Cubesat-EPS-Project/Final_EPS_Version2/Docs/EPS_FINAL_FRONT.png

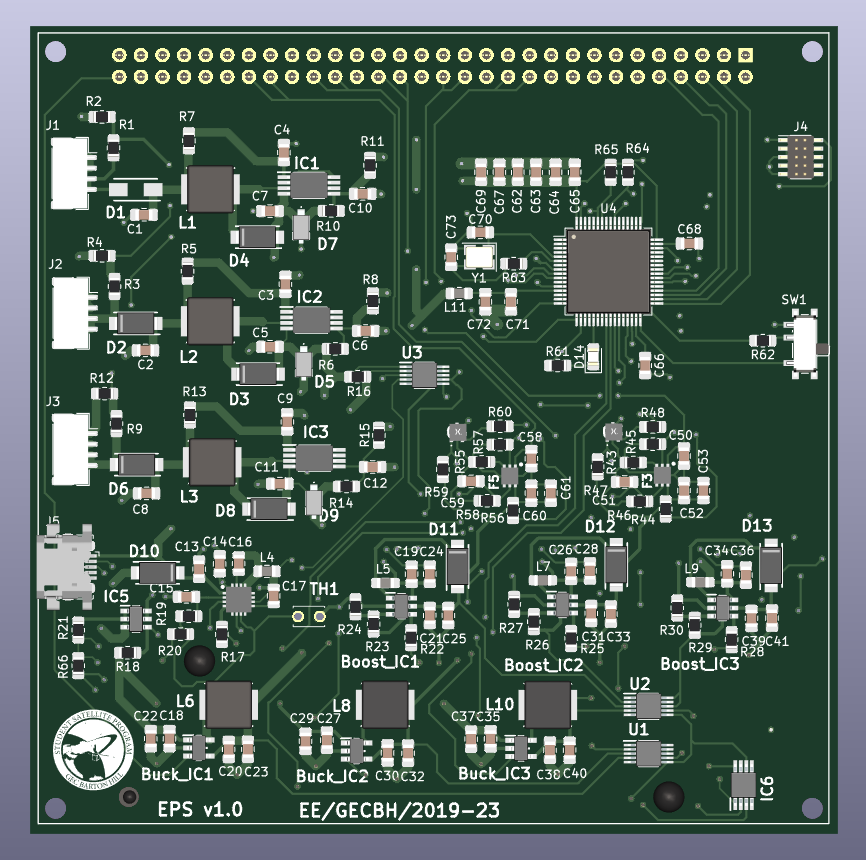
Docs/EPS_FINAL_FRONT.png
