Cubesat-EPS-Project/Final_EPS_Version2/FinalBoardCircuits/FinalBoardCircuits.kicad_pcb

## KiCad design FinalBoardCircuits/FinalBoardCircuits.kicad_pcb (2023-06-03)

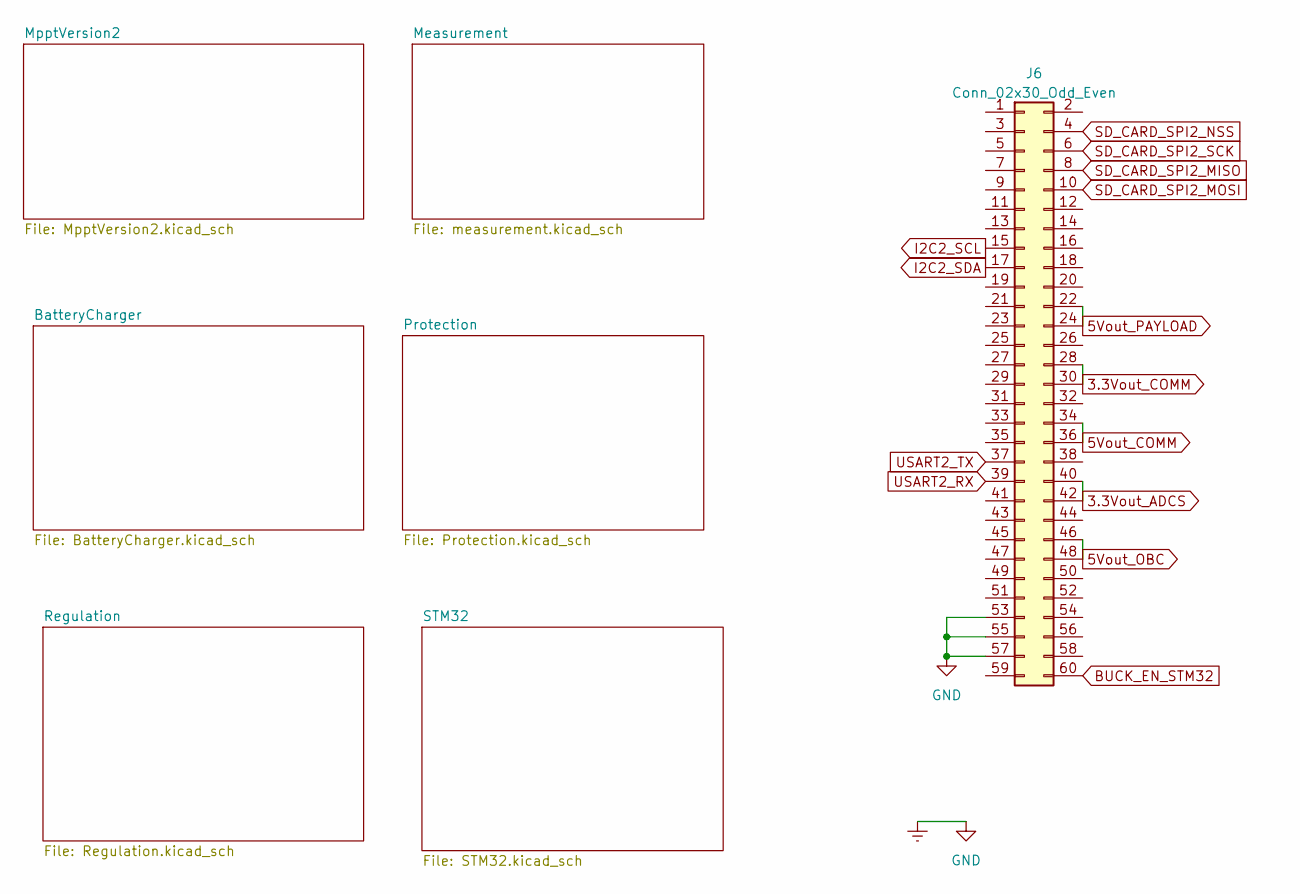
[picture p3: schematic FinalBoardCircuits.kicad_sch]

Parts:
J6: Conn_02x30_Odd_Even; PinSocket_2x30_P2.54mm_Vertical

Connections:
3.3Vout_ADCS: J6.40, J6.42; also elsewhere on the board
3.3Vout_COMM: J6.28, J6.30; also elsewhere on the board
5Vout_COMM: J6.34, J6.36; also elsewhere on the board
5Vout_OBC: J6.46, J6.48; also elsewhere on the board
5Vout_PAYLOAD: J6.22, J6.24; also elsewhere on the board
BUCK_EN_STM32: J6.60; also elsewhere on the board
I2C2_SCL: J6.15; also elsewhere on the board
I2C2_SDA: J6.17; also elsewhere on the board
SD_CARD_SPI2_MISO: J6.8; also elsewhere on the board
SD_CARD_SPI2_MOSI: J6.10; also elsewhere on the board
SD_CARD_SPI2_NSS: J6.4; also elsewhere on the board
SD_CARD_SPI2_SCK: J6.6; also elsewhere on the board
USART2_RX: J6.39; also elsewhere on the board
USART2_TX: J6.37; also elsewhere on the board

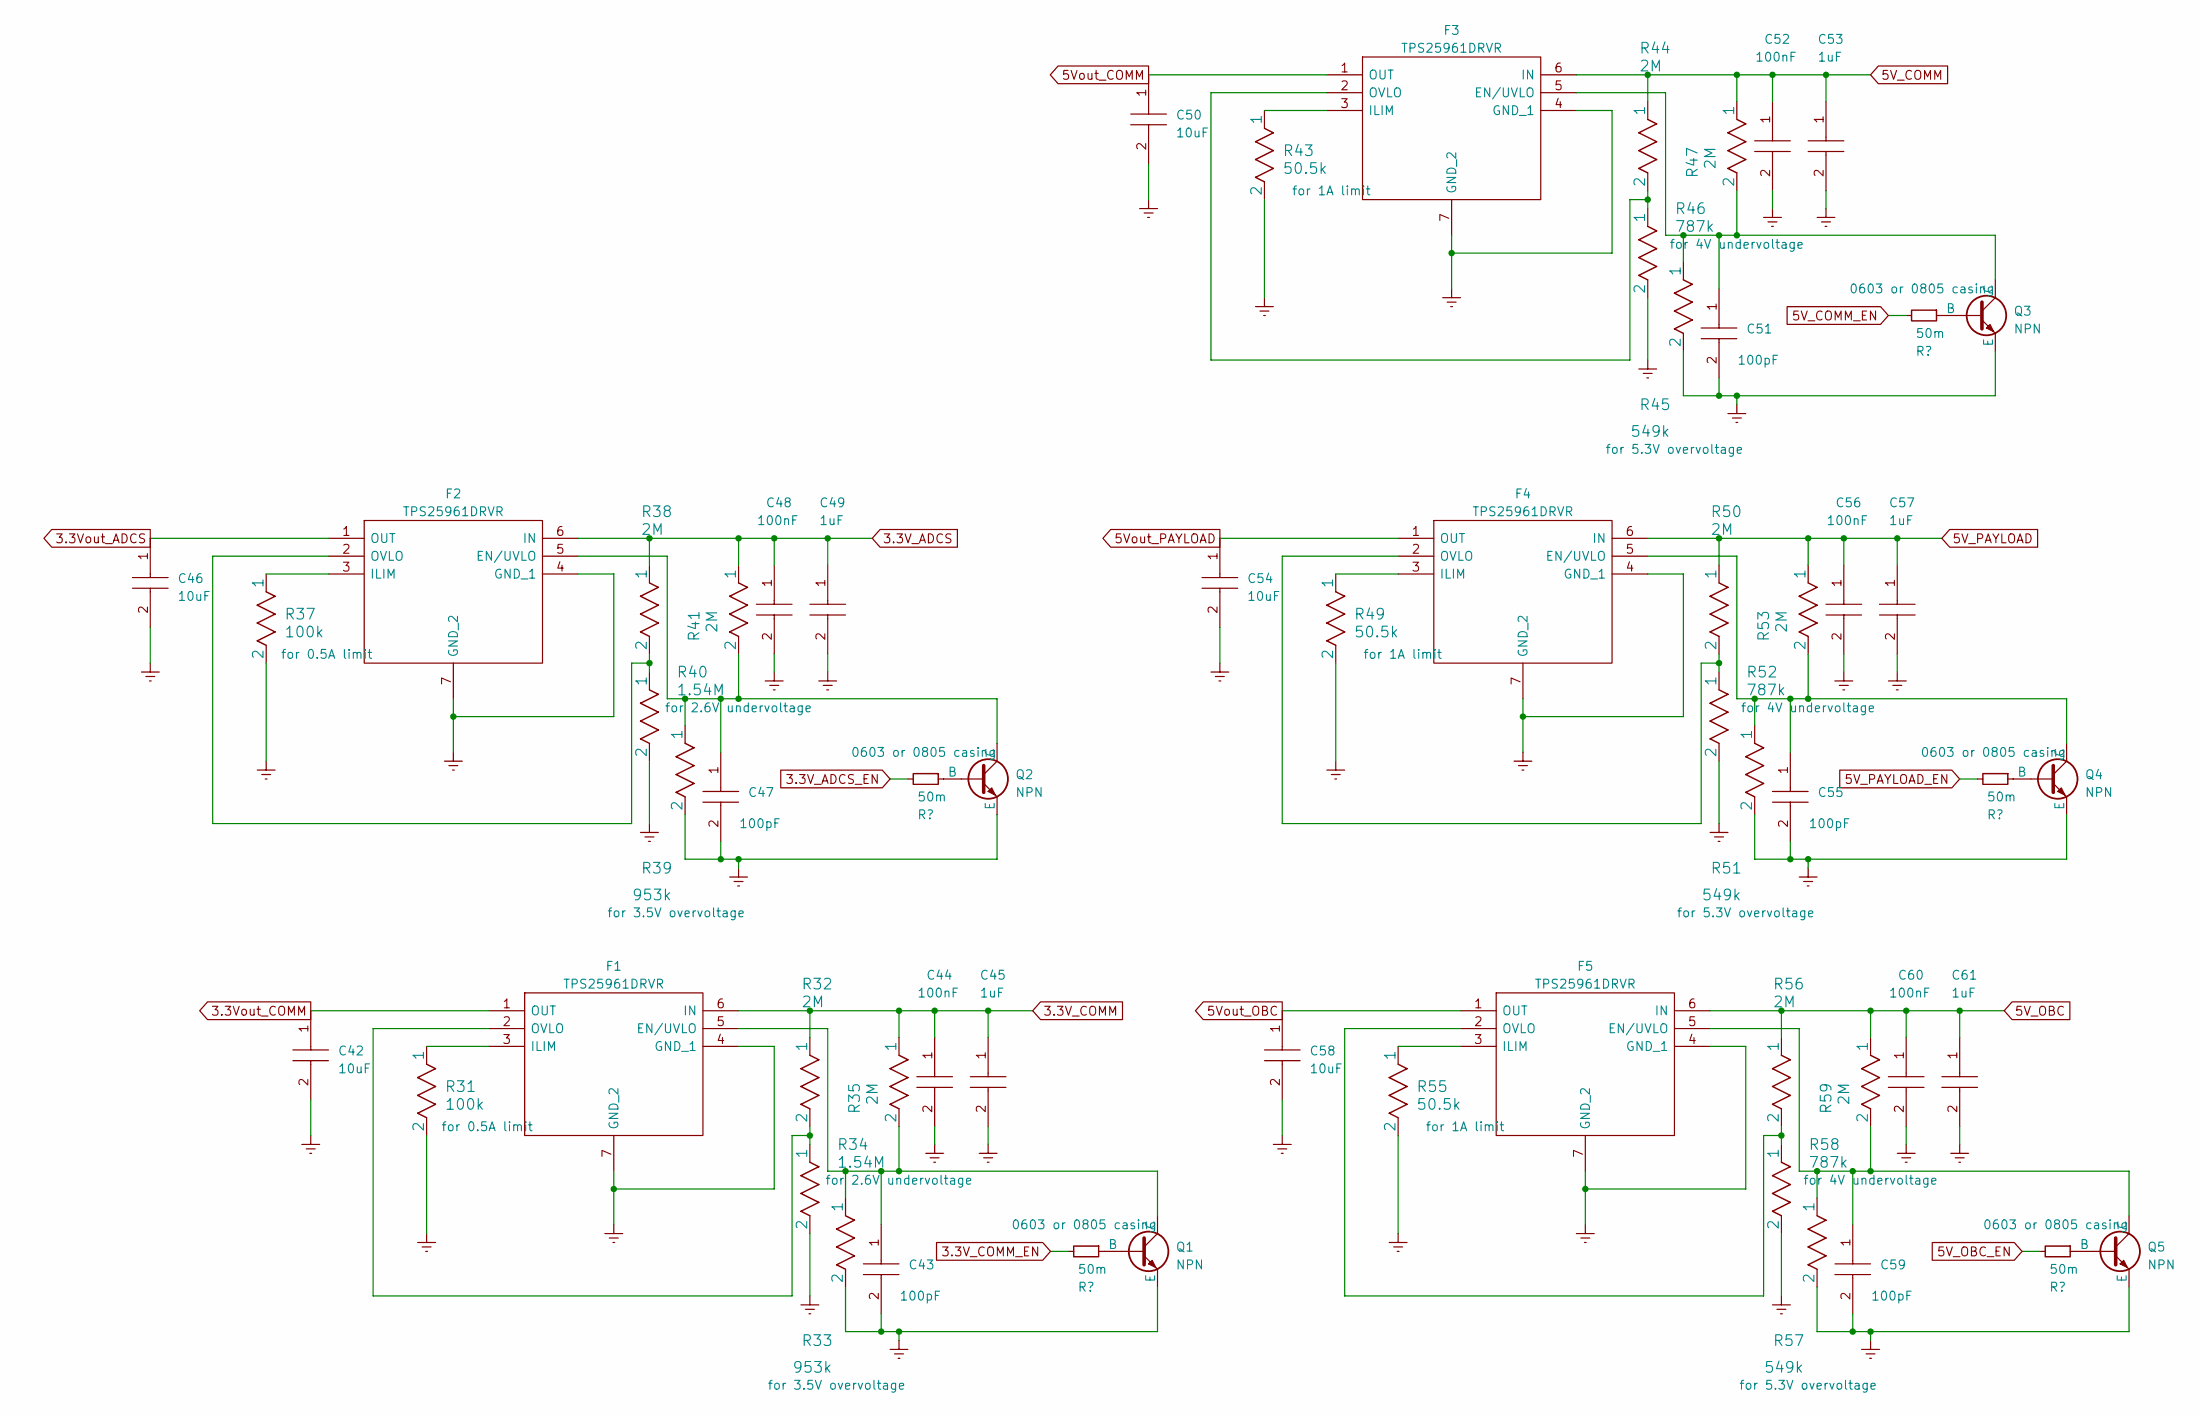
[picture p4: schematic Protection.kicad_sch]

Parts:
C42, C46, C50, C54, C58: 10uF; C_0805_2012Metric_Pad1.18x1.45mm_HandSolder; Mouser Part Number 581-0805YC106KAT2A
C43, C47, C51, C55, C59: 100pF; C_0805_2012Metric_Pad1.18x1.45mm_HandSolder; Mouser Part Number 80-C0402C101K3RAUTO
C44, C48, C52, C56, C60: 100nF; C_0805_2012Metric_Pad1.18x1.45mm_HandSolder; Mouser Part Number 810-C1005X7R1C104K
C45, C49, C53, C57, C61: 1uF; C_0805_2012Metric_Pad1.18x1.45mm_HandSolder; Mouser Part Number 80-C2220X105K2RAUTO
F1, F2, F3, F4, F5: TPS25961DRVR; SON65P200X200X80-7N; Mouser Part Number 595-TPS25961DRVR
Q1, Q2, Q3, Q4, Q5: NPN; PBSS4310PASQX
R31, R37: 100k; R_0805_2012Metric_Pad1.20x1.40mm_HandSolder
R32, R35, R38, R41, R44, R47, R50, R53, R56, R59: 2M; R_0805_2012Metric_Pad1.20x1.40mm_HandSolder
R33, R39: 953k; R_0805_2012Metric_Pad1.20x1.40mm_HandSolder
R34, R40: 1.54M; R_0805_2012Metric_Pad1.20x1.40mm_HandSolder
R36, R42, R48, R54, R60: 50m; R_0805_2012Metric_Pad1.20x1.40mm_HandSolder
R43, R49, R55: 50.5k; R_0805_2012Metric_Pad1.20x1.40mm_HandSolder
R45, R51, R57: 549k; R_0805_2012Metric_Pad1.20x1.40mm_HandSolder
R46, R52, R58: 787k; R_0805_2012Metric_Pad1.20x1.40mm_HandSolder

Connections:
3.3V_ADCS: C48.1, C49.1, F2.6 (IN), R38.1, R41.1; also elsewhere on the board
3.3V_ADCS_EN: R42.2; also elsewhere on the board
3.3V_COMM: C44.1, C45.1, F1.6 (IN), R32.1, R35.1; also elsewhere on the board
3.3V_COMM_EN: R36.2; also elsewhere on the board
3.3Vout_ADCS: C46.1, F2.1 (OUT); also elsewhere on the board
3.3Vout_COMM: C42.1, F1.1 (OUT); also elsewhere on the board
5V_COMM: C52.1, C53.1, F3.6 (IN), R44.1, R47.1; also elsewhere on the board
5V_COMM_EN: R48.2; also elsewhere on the board
5V_OBC: C60.1, C61.1, F5.6 (IN), R56.1, R59.1; also elsewhere on the board
5V_OBC_EN: R60.2; also elsewhere on the board
5V_PAYLOAD: C56.1, C57.1, F4.6 (IN), R50.1, R53.1; also elsewhere on the board
5V_PAYLOAD_EN: R54.2; also elsewhere on the board
5Vout_COMM: C50.1, F3.1 (OUT); also elsewhere on the board
5Vout_OBC: C58.1, F5.1 (OUT); also elsewhere on the board
5Vout_PAYLOAD: C54.1, F4.1 (OUT); also elsewhere on the board
unnamed: C43.1, F1.5 (EN/UVLO), Q1.1 (C), R34.1, R35.2
unnamed: F1.3 (ILIM), R31.1
unnamed: F1.2 (OVLO), R32.2, R33.1
unnamed: C47.1, F2.5 (EN/UVLO), Q2.1 (C), R40.1, R41.2
unnamed: F2.3 (ILIM), R37.1
unnamed: F2.2 (OVLO), R38.2, R39.1
unnamed: C51.1, F3.5 (EN/UVLO), Q3.1 (C), R46.1, R47.2
unnamed: F3.3 (ILIM), R43.1
unnamed: F3.2 (OVLO), R44.2, R45.1
unnamed: C55.1, F4.5 (EN/UVLO), Q4.1 (C), R52.1, R53.2
unnamed: F4.3 (ILIM), R49.1
unnamed: F4.2 (OVLO), R50.2, R51.1
unnamed: C59.1, F5.5 (EN/UVLO), Q5.1 (C), R58.1, R59.2
unnamed: F5.3 (ILIM), R55.1
unnamed: F5.2 (OVLO), R56.2, R57.1
unnamed: Q1.2 (B), R36.1
unnamed: Q2.2 (B), R42.1
unnamed: Q3.2 (B), R48.1
unnamed: Q4.2 (B), R54.1
unnamed: Q5.2 (B), R60.1

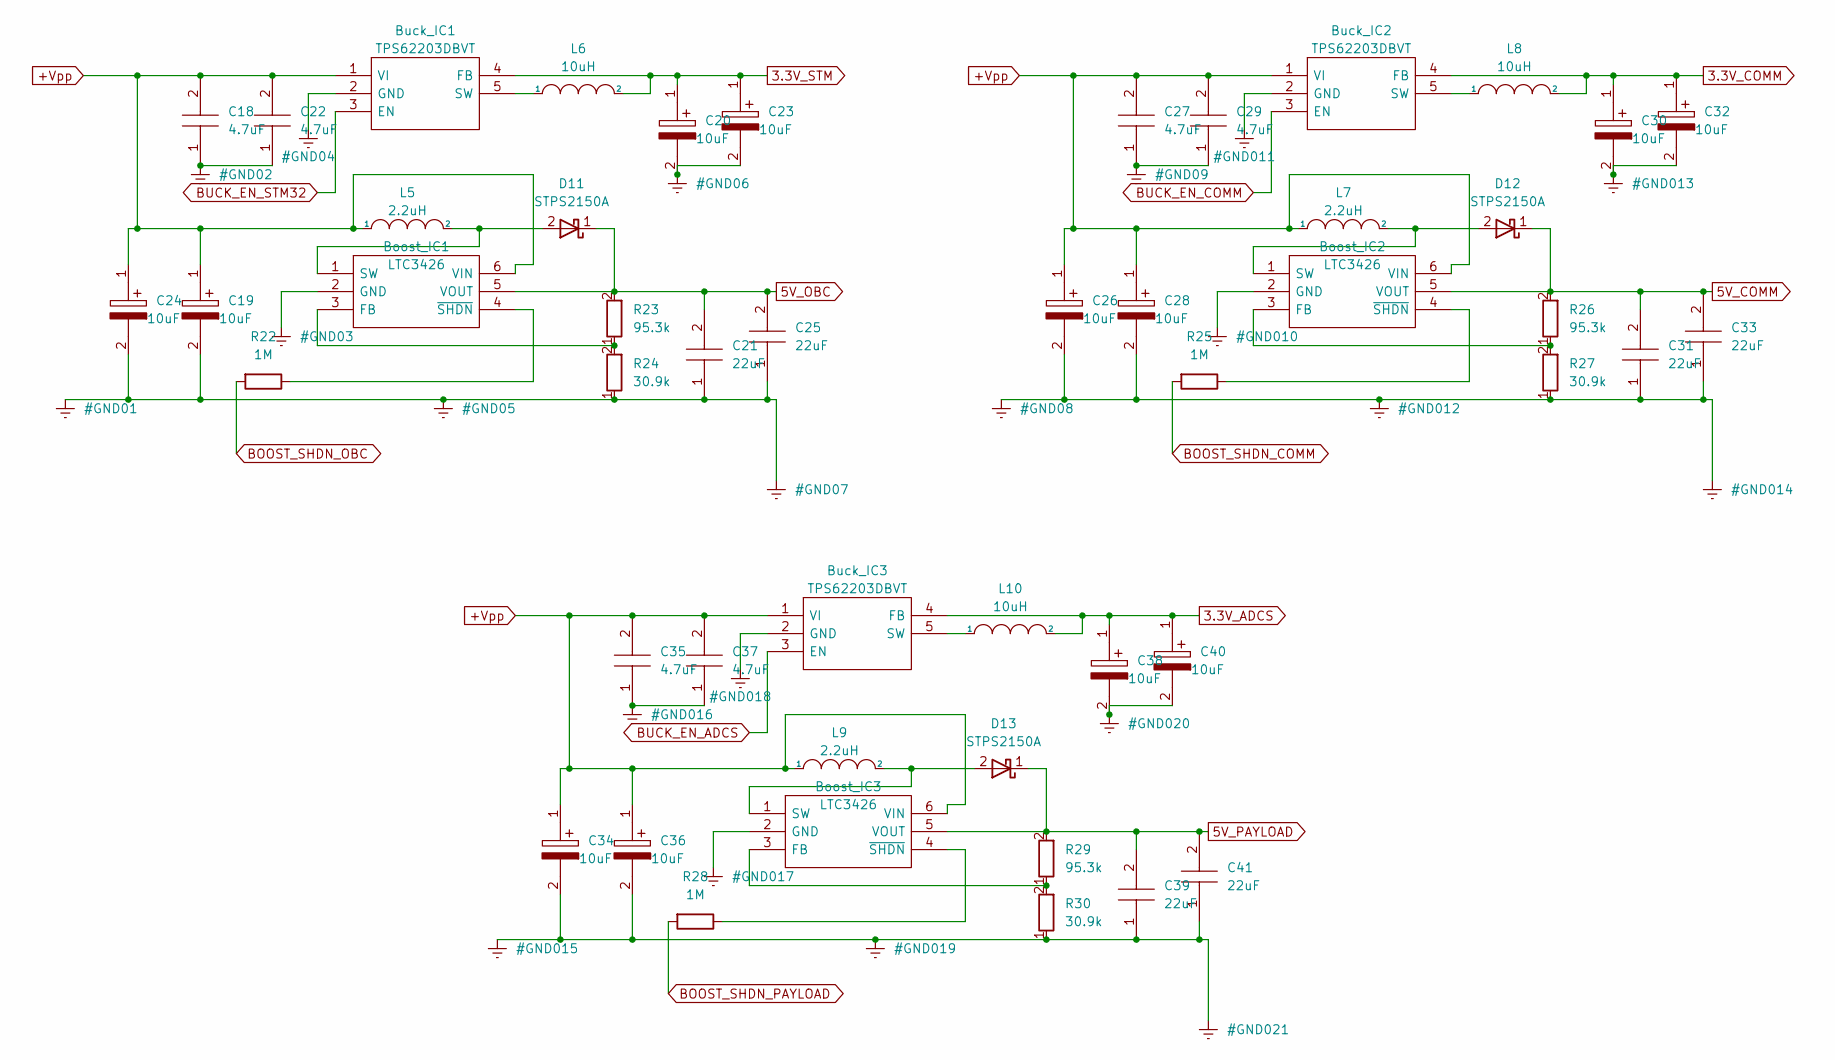
[picture p5: schematic Regulation.kicad_sch]

Parts:
Boost_IC1, Boost_IC2, Boost_IC3: LTC3426; SOT95P280X90-6N; Mouser Part Number 584-LTC3426ES6TRMPBF
Buck_IC1, Buck_IC2, Buck_IC3: TPS62203DBVT; SOT95P280X145-5N; Mouser Part Number 595-TPS62203DBVT
C18, C22, C27, C29, C35, C37: 4.7uF; C_0805_2012Metric_Pad1.18x1.45mm_HandSolder; Mouser Part Number 80-C1210C475K4RAUTO
C19, C20, C23, C24, C26, C28, C30, C32, C34, C36, C38, C40: 10uF; C_0805_2012Metric_Pad1.18x1.45mm_HandSolder; Mouser Part Number 598-AFK106M35C12T-F
C21, C25, C31, C33, C39, C41: 22uF; C_0805_2012Metric_Pad1.18x1.45mm_HandSolder; Mouser Part Number 81-ZRB18AR61A226ME1L
D11, D12, D13: STPS2150A
L5, L7, L9: 2.2uH; L_0805_2012Metric_Pad1.05x1.20mm_HandSolder
L6, L8, L10: 10uH; B82442T1103K050
R22, R25, R28: 1M; R_0805_2012Metric_Pad1.20x1.40mm_HandSolder
R23, R26, R29: 95.3k; R_0805_2012Metric_Pad1.20x1.40mm_HandSolder
R24, R27, R30: 30.9k; R_0805_2012Metric_Pad1.20x1.40mm_HandSolder

Connections:
3.3V_ADCS: Buck_IC3.4 (FB), C38.1, C40.1, L10.2; also elsewhere on the board
3.3V_COMM: Buck_IC2.4 (FB), C30.1, C32.1, L8.2; also elsewhere on the board
3.3V_STM: Buck_IC1.4 (FB), C20.1, C23.1, L6.2; also elsewhere on the board
5V_COMM: Boost_IC2.5 (VOUT), C31.2, C33.2, D12.1 (K), R26.2; also elsewhere on the board
5V_OBC: Boost_IC1.5 (VOUT), C21.2, C25.2, D11.1 (K), R23.2; also elsewhere on the board
5V_PAYLOAD: Boost_IC3.5 (VOUT), C39.2, C41.2, D13.1 (K), R29.2; also elsewhere on the board
+Vpp: Boost_IC1.6 (VIN), Boost_IC2.6 (VIN), Boost_IC3.6 (VIN), Buck_IC1.1 (VI), Buck_IC2.1 (VI), Buck_IC3.1 (VI), C18.2, C19.1, C22.2, C24.1, C26.1, C27.2, C28.1, C29.2, C34.1, C35.2, C36.1, C37.2, L5.1, L7.1, L9.1; also elsewhere on the board
BOOST_SHDN_COMM: R25.2; also elsewhere on the board
BOOST_SHDN_OBC: R22.2; also elsewhere on the board
BOOST_SHDN_PAYLOAD: R28.2; also elsewhere on the board
BUCK_EN_ADCS: Buck_IC3.3 (EN); also elsewhere on the board
BUCK_EN_COMM: Buck_IC2.3 (EN); also elsewhere on the board
BUCK_EN_STM32: Buck_IC1.3 (EN); also elsewhere on the board
unnamed: Boost_IC1.3 (FB), R23.1, R24.2
unnamed: Boost_IC1.1 (SW), D11.2 (A), L5.2
unnamed: Boost_IC1.4 (~SHDN), R22.1
unnamed: Boost_IC2.3 (FB), R26.1, R27.2
unnamed: Boost_IC2.1 (SW), D12.2 (A), L7.2
unnamed: Boost_IC2.4 (~SHDN), R25.1
unnamed: Boost_IC3.3 (FB), R29.1, R30.2
unnamed: Boost_IC3.1 (SW), D13.2 (A), L9.2
unnamed: Boost_IC3.4 (~SHDN), R28.1
unnamed: Buck_IC1.5 (SW), L6.1
unnamed: Buck_IC2.5 (SW), L8.1
unnamed: Buck_IC3.5 (SW), L10.1

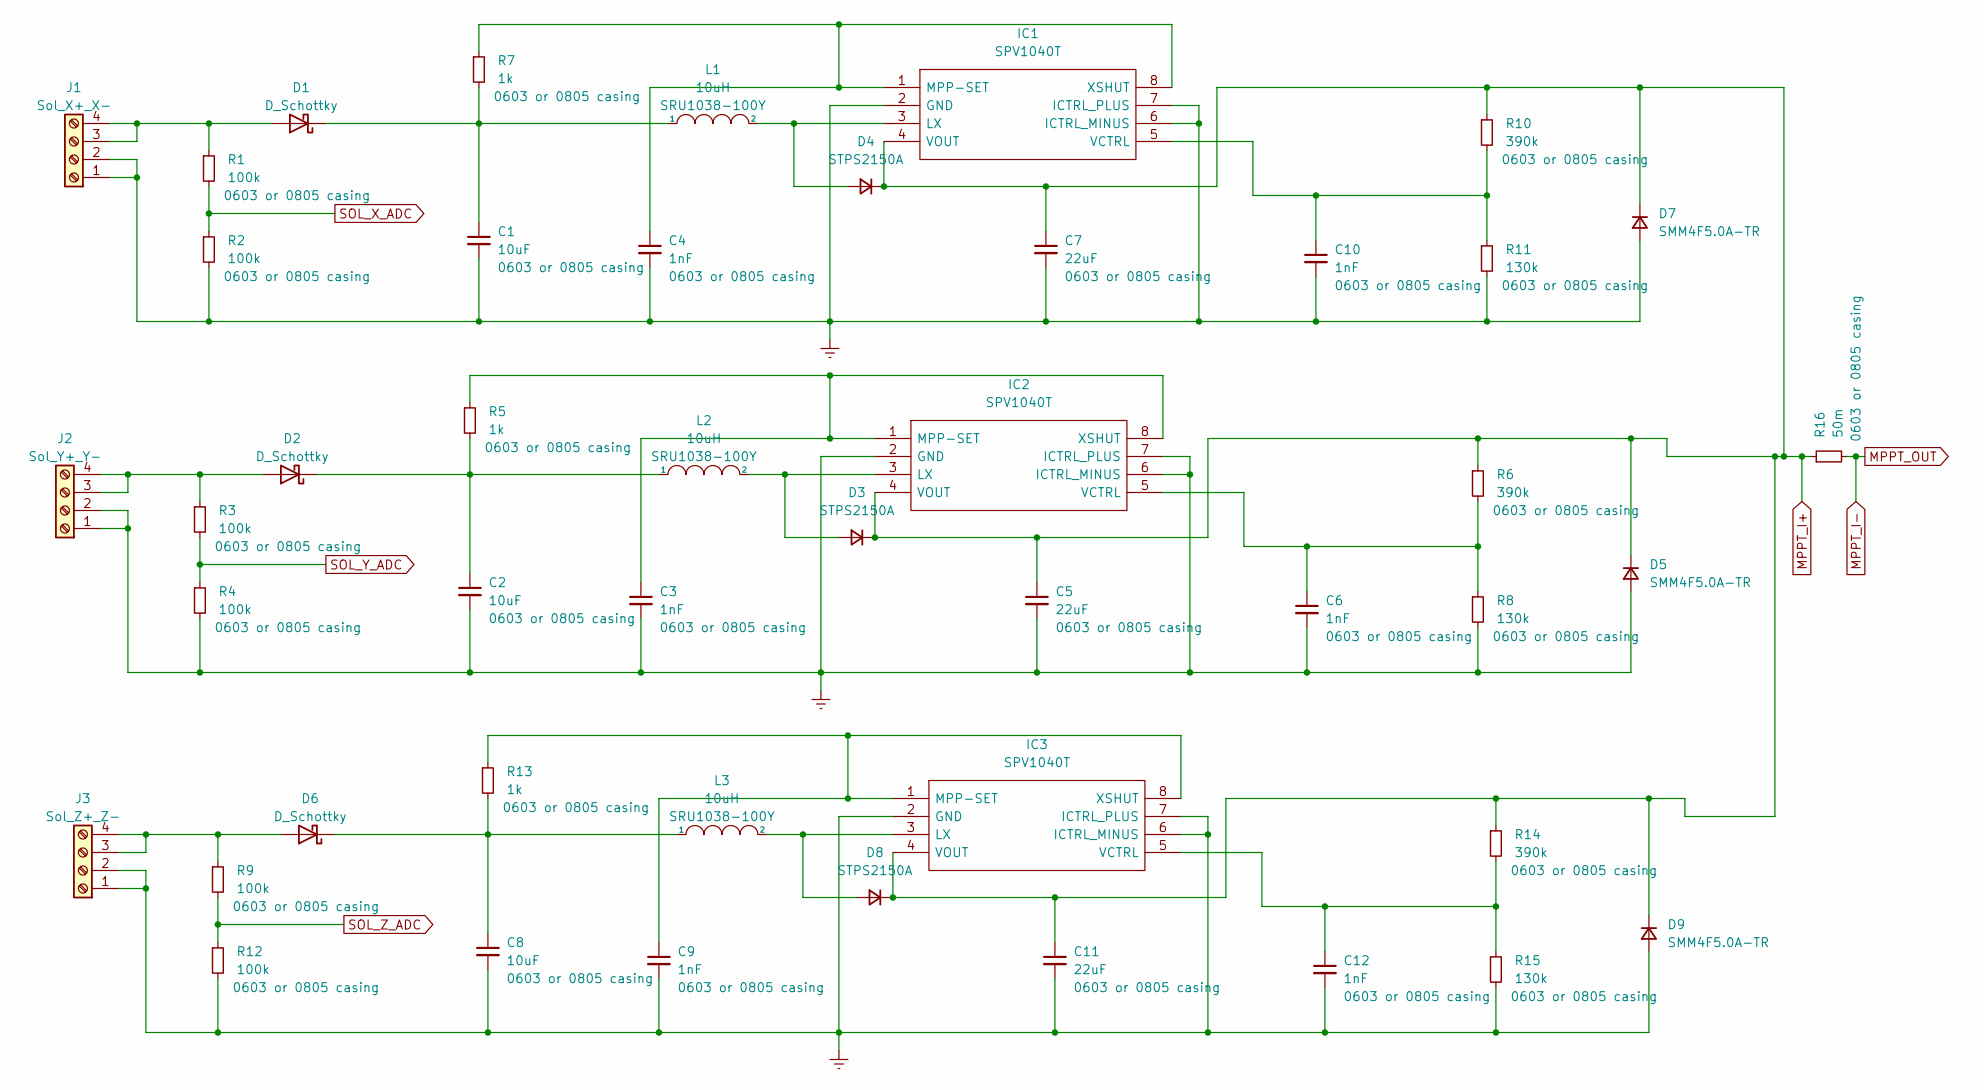
[picture p6: schematic MpptVersion2.kicad_sch]

Parts:
C1, C2, C8: 10uF; C_0805_2012Metric_Pad1.18x1.45mm_HandSolder
C3, C4, C6, C9, C10, C12: 1nF; C_0805_2012Metric_Pad1.18x1.45mm_HandSolder
C5, C7, C11: 22uF; C_0805_2012Metric_Pad1.18x1.45mm_HandSolder
D1, D2, D6: D_Schottky; STPS2150A
D3, D4, D8: STPS2150A
D5, D7, D9: SMM4F5.0A-TR
IC1, IC2, IC3: SPV1040T; Mouser Part Number 511-SPV1040T
J1: Sol_X+_X-; JST_GH_SM04B-GHS-TB_1x04-1MP_P1.25mm_Horizontal
J2: Sol_Y+_Y-; JST_GH_SM04B-GHS-TB_1x04-1MP_P1.25mm_Horizontal
J3: Sol_Z+_Z-; JST_GH_SM04B-GHS-TB_1x04-1MP_P1.25mm_Horizontal
L1, L2, L3: 10uH; B82442T1103K050
R1, R2, R3, R4, R9, R12: 100k; R_0805_2012Metric_Pad1.20x1.40mm_HandSolder
R5, R7, R13: 1k; R_0805_2012Metric_Pad1.20x1.40mm_HandSolder
R6, R10, R14: 390k; R_0805_2012Metric_Pad1.20x1.40mm_HandSolder
R8, R11, R15: 130k; R_0805_2012Metric_Pad1.20x1.40mm_HandSolder
R16: 50m; R_0805_2012Metric_Pad1.20x1.40mm_HandSolder

Connections:
MPPT_I+: C5.1, C7.1, C11.1, D3.1 (K), D4.1 (K), D5.1 (K), D5.3, D7.1 (K), D7.3, D8.1 (K), D9.1 (K), D9.3, IC1.4 (VOUT), IC2.4 (VOUT), IC3.4 (VOUT), R6.1, R10.1, R14.1, R16.1; also elsewhere on the board
MPPT_I-: R16.2; also elsewhere on the board
unnamed: C1.1, D1.1 (K), L1.1, R7.2
unnamed: D2.2 (A), J2.3, J2.4, R3.1
unnamed: C2.1, D2.1 (K), L2.1, R5.2
unnamed: D3.2 (A), IC2.3 (LX), L2.2
unnamed: D4.2 (A), IC1.3 (LX), L1.2
unnamed: D6.2 (A), J3.3, J3.4, R9.1
unnamed: C8.1, D6.1 (K), L3.1, R13.2
unnamed: D8.2 (A), IC3.3 (LX), L3.2
unnamed: C10.1, IC1.5 (VCTRL), R10.2, R11.1
unnamed: C3.1, IC2.1 (MPP-SET), IC2.8 (XSHUT), R5.1
unnamed: C6.1, IC2.5 (VCTRL), R6.2, R8.1
unnamed: C9.1, IC3.1 (MPP-SET), IC3.8 (XSHUT), R13.1
unnamed: C12.1, IC3.5 (VCTRL), R14.2, R15.1
SOL_Y_ADC: R3.2, R4.1; also elsewhere on the board
SOL_Z_ADC: R9.2, R12.1; also elsewhere on the board

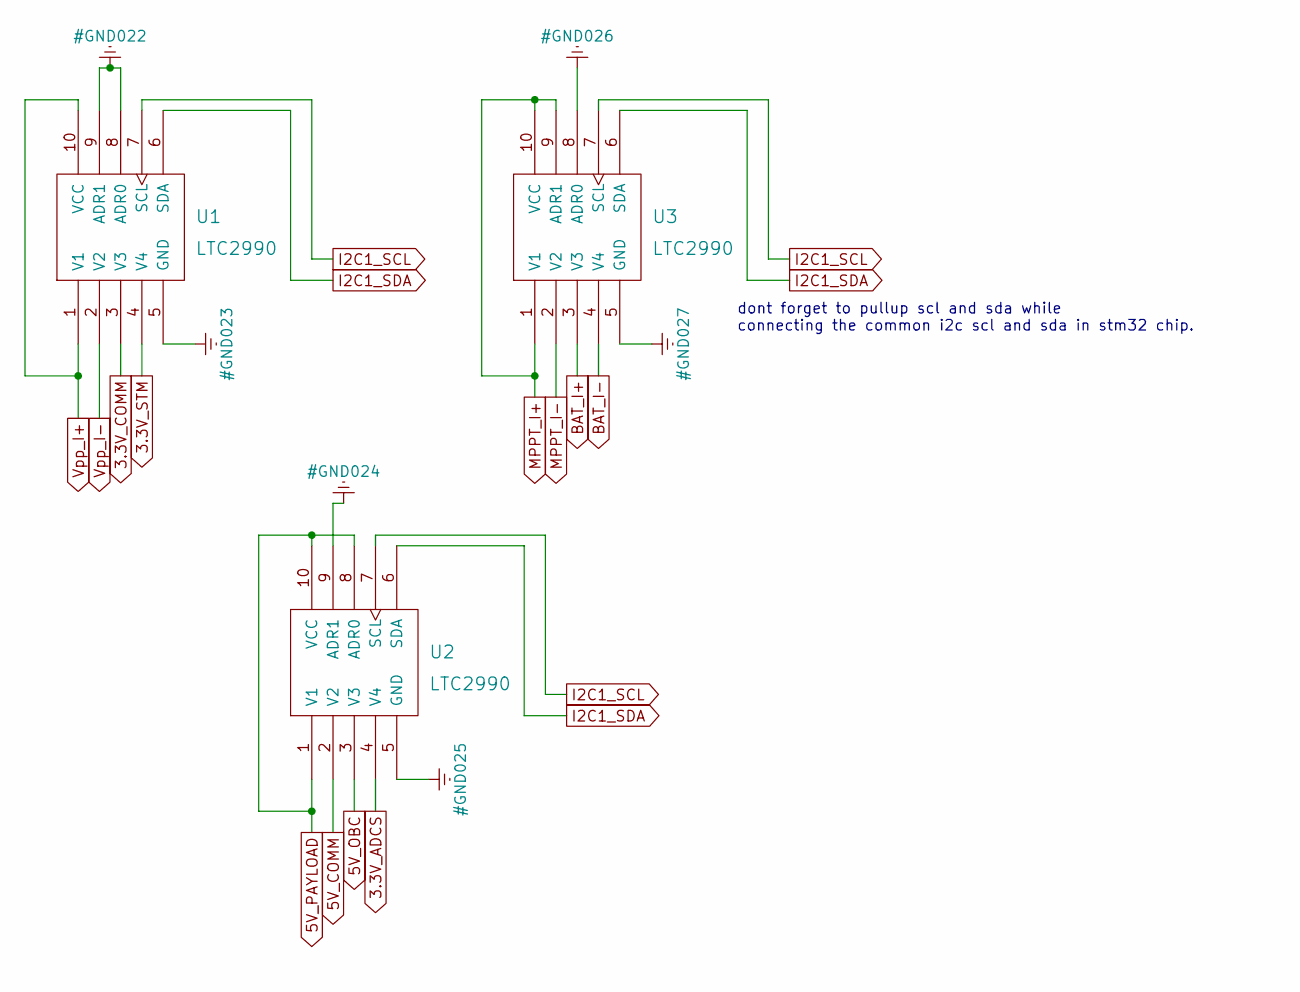
[picture p7: schematic measurement.kicad_sch]

Parts:
U1, U2, U3: LTC2990; SOP50P490X110-10N

Connections:
3.3V_ADCS: U2.4 (V4); also elsewhere on the board
3.3V_COMM: U1.3 (V3); also elsewhere on the board
3.3V_STM: U1.4 (V4); also elsewhere on the board
5V_COMM: U2.2 (V2); also elsewhere on the board
5V_OBC: U2.3 (V3); also elsewhere on the board
5V_PAYLOAD: U2.1 (V1), U2.8 (ADR0), U2.10 (VCC); also elsewhere on the board
+Vpp: U1.2 (V2); also elsewhere on the board
BAT_I+: U3.3 (V3); also elsewhere on the board
I2C1_SCL: U1.7 (SCL), U2.7 (SCL), U3.7 (SCL); also elsewhere on the board
I2C1_SDA: U1.6 (SDA), U2.6 (SDA), U3.6 (SDA); also elsewhere on the board
MPPT_I+: U3.1 (V1), U3.9 (ADR1), U3.10 (VCC); also elsewhere on the board
MPPT_I-: U3.2 (V2); also elsewhere on the board
Vpp_I+: U1.1 (V1), U1.10 (VCC)

Notes on the sheet:
dont forget to pullup scl and sda while connecting the common i2c scl and sda in stm32 chip.

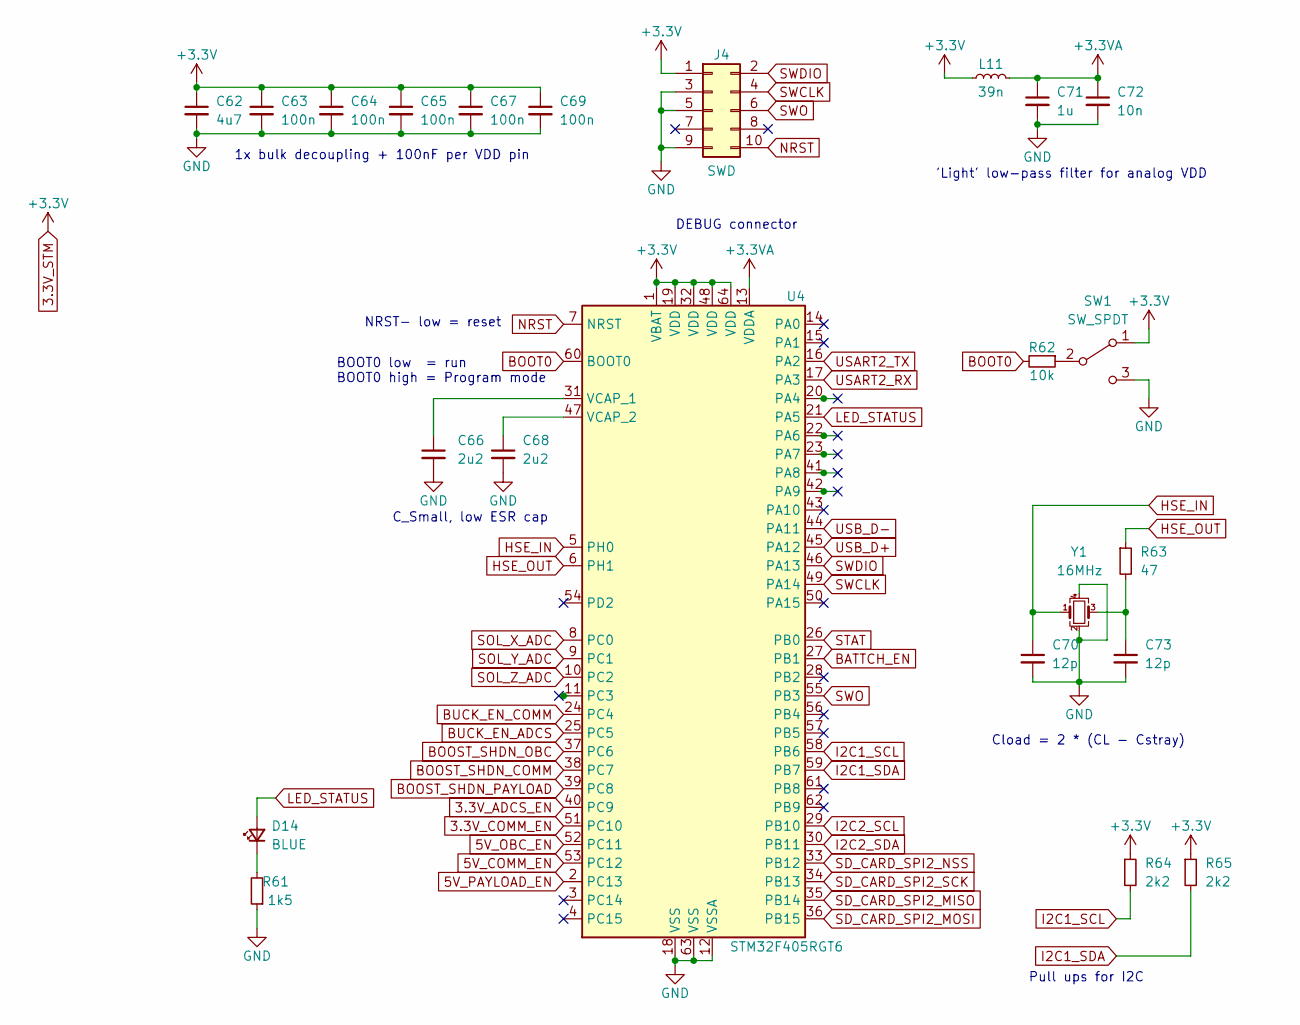
[picture p8: schematic STM32.kicad_sch]

Parts:
C62: 4u7; C_0805_2012Metric_Pad1.18x1.45mm_HandSolder; LCSC Part # C19666
C63, C64, C65, C67, C69: 100n; C_0805_2012Metric_Pad1.18x1.45mm_HandSolder; LCSC Part # C1525
C66, C68: 2u2; C_0805_2012Metric_Pad1.18x1.45mm_HandSolder; LCSC Part # C23630
C70, C73: 12p; C_0805_2012Metric_Pad1.18x1.45mm_HandSolder; LCSC Part # C1547
C71: 1u; C_0805_2012Metric_Pad1.18x1.45mm_HandSolder; LCSC Part # C52923
C72: 10n; C_0805_2012Metric_Pad1.18x1.45mm_HandSolder; LCSC Part # C15195
D14: BLUE; LED_0805_2012Metric_Pad1.15x1.40mm_HandSolder; LCSC Part # C72041
J4: SWD; PinHeader_2x05_P1.00mm_Vertical_SMD
L11: 39n; L_0805_2012Metric_Pad1.15x1.40mm_HandSolder; LCSC Part # C26443
R61: 1k5; R_0805_2012Metric_Pad1.20x1.40mm_HandSolder; LCSC Part # C22843
R62: 10k; R_0805_2012Metric_Pad1.20x1.40mm_HandSolder; LCSC Part # C25744
R63: 47; R_0805_2012Metric_Pad1.20x1.40mm_HandSolder; LCSC Part # C25118
R64, R65: 2k2; R_0805_2012Metric_Pad1.20x1.40mm_HandSolder; LCSC Part # C25879
SW1: SW_SPDT; SW_SPDT_PCM12
U4: STM32F405RGT6; LQFP-64_10x10mm_P0.5mm; LCSC Part # C15742
Y1: 16MHz; Crystal_SMD_3225-4Pin_3.2x2.5mm; LCSC Part # C13738

Connections:
3.3V_ADCS_EN: U4.40 (PC9); also elsewhere on the board
3.3V_COMM_EN: U4.51 (PC10); also elsewhere on the board
3.3V_STM: C62.1, C63.1, C64.1, C65.1, C67.1, C69.1, J4.1, L11.1, R64.1, R65.1, SW1.1 (A), U4.1 (VBAT), U4.19 (VDD), U4.32 (VDD), U4.48 (VDD), U4.64 (VDD); also elsewhere on the board
5V_COMM_EN: U4.53 (PC12); also elsewhere on the board
5V_OBC_EN: U4.52 (PC11); also elsewhere on the board
5V_PAYLOAD_EN: U4.2 (PC13); also elsewhere on the board
+3.3VA: C71.1, C72.1, L11.2, U4.13 (VDDA)
BATTCH_EN: U4.27 (PB1); also elsewhere on the board
BOOST_SHDN_COMM: U4.38 (PC7); also elsewhere on the board
BOOST_SHDN_OBC: U4.37 (PC6); also elsewhere on the board
BOOST_SHDN_PAYLOAD: U4.39 (PC8); also elsewhere on the board
BOOT0: R62.2, U4.60 (BOOT0)
BUCK_EN_ADCS: U4.25 (PC5); also elsewhere on the board
BUCK_EN_COMM: U4.24 (PC4); also elsewhere on the board
HSE_IN: C70.1, U4.5 (PH0), Y1.1
HSE_OUT: R63.1, U4.6 (PH1)
I2C1_SCL: R64.2, U4.58 (PB6); also elsewhere on the board
I2C1_SDA: R65.2, U4.59 (PB7); also elsewhere on the board
I2C2_SCL: U4.29 (PB10); also elsewhere on the board
I2C2_SDA: U4.30 (PB11); also elsewhere on the board
LED_STATUS: D14.2 (A), U4.21 (PA5)
NRST: J4.10, U4.7 (NRST)
unnamed: C73.1, R63.2, Y1.3
unnamed: D14.1 (K), R61.2
unnamed: R62.1, SW1.2 (B)
unnamed: C66.1, U4.31 (VCAP_1)
unnamed: C68.1, U4.47 (VCAP_2)
SD_CARD_SPI2_MISO: U4.35 (PB14); also elsewhere on the board
SD_CARD_SPI2_MOSI: U4.36 (PB15); also elsewhere on the board
SD_CARD_SPI2_NSS: U4.33 (PB12); also elsewhere on the board
SD_CARD_SPI2_SCK: U4.34 (PB13); also elsewhere on the board
SOL_Y_ADC: U4.9 (PC1); also elsewhere on the board
SOL_Z_ADC: U4.10 (PC2); also elsewhere on the board
STAT: U4.26 (PB0); also elsewhere on the board
SWCLK: J4.4, U4.49 (PA14)
SWDIO: J4.2, U4.46 (PA13)
SWO: J4.6, U4.55 (PB3)
USART2_RX: U4.17 (PA3); also elsewhere on the board
USART2_TX: U4.16 (PA2); also elsewhere on the board
USB_D+: U4.45 (PA12); also elsewhere on the board
USB_D-: U4.44 (PA11); also elsewhere on the board

Notes on the sheet:
BOOT0 low = run BOOT0 high = Program mode
NRST- low = reset
Cload = 2 * (CL - Cstray)
DEBUG connector
1x bulk decoupling + 100nF per VDD pin
Pull ups for I2C
'Light' low-pass filter for analog VDD
C_Small, low ESR cap

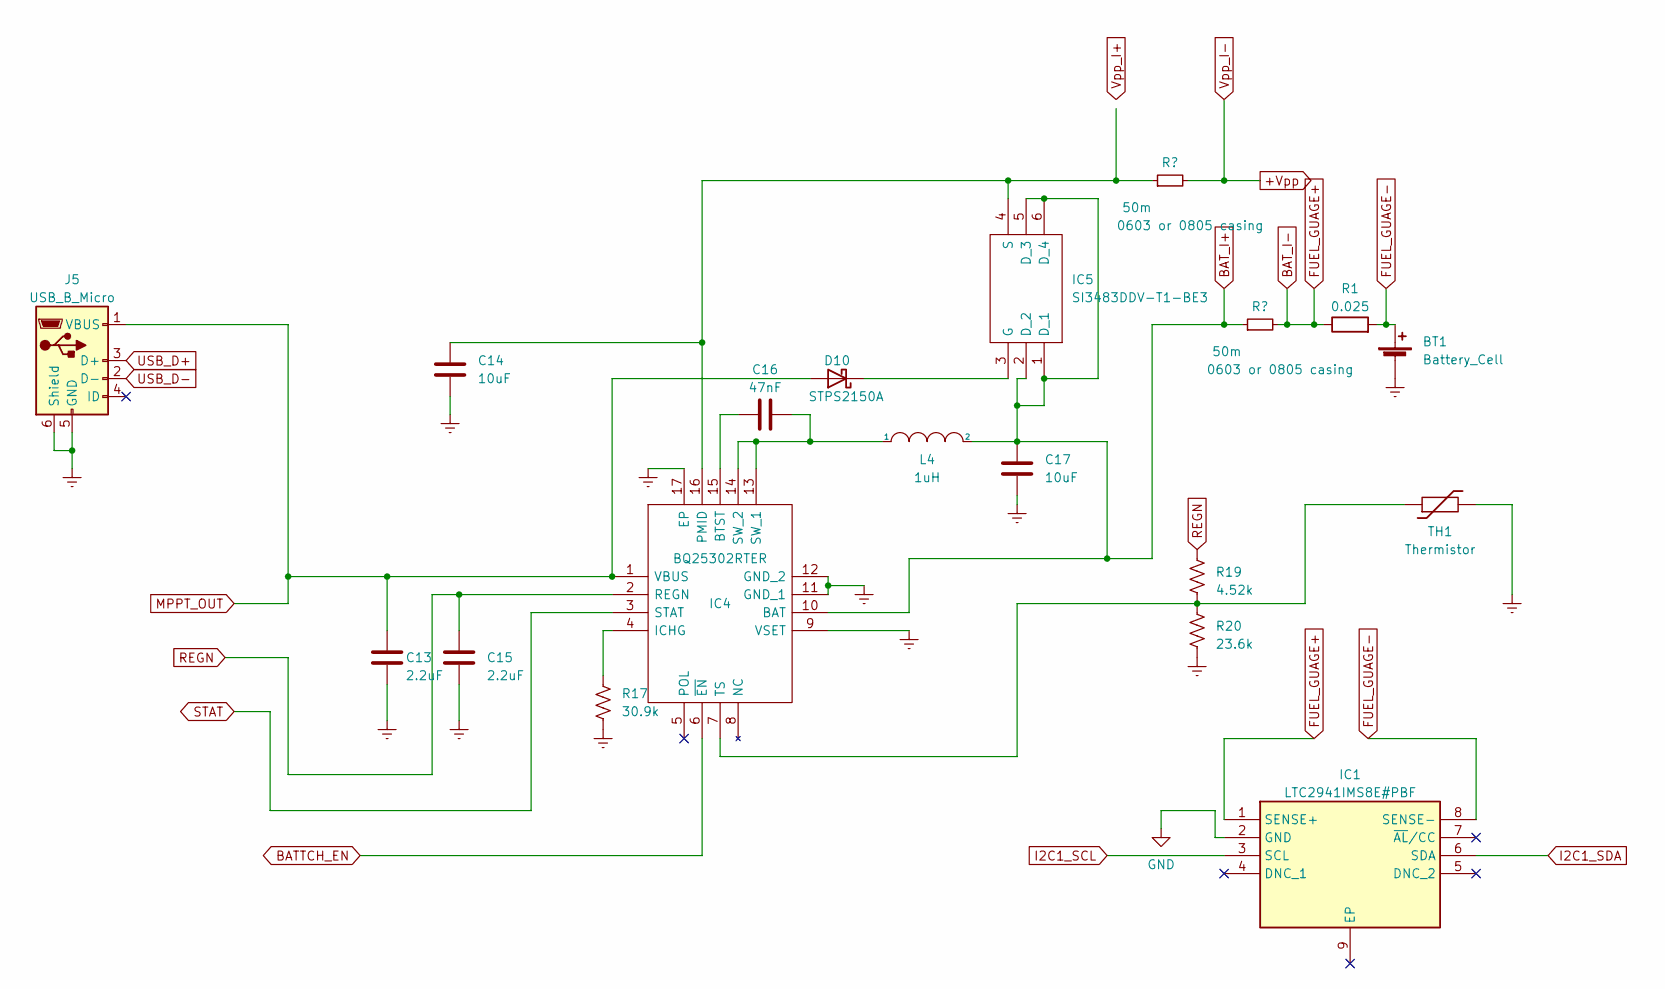
[picture p9: schematic BatteryCharger.kicad_sch]

Parts:
BT1: Battery_Cell; BatteryHolder_Keystone_1042_1x18650
C13, C15: 2.2uF; C_0805_2012Metric_Pad1.18x1.45mm_HandSolder
C14: 10uF; C_0805_2012Metric_Pad1.18x1.45mm_HandSolder
C16: 47nF; C_0805_2012Metric
C17: 10uF; C_0805_2012Metric
D10: STPS2150A
IC1: LTC2941IMS8E#PBF; SOP65P490X110-9N; Mouser Part Number 584-LTC2941IMS8E#PBF
IC4: BQ25302RTER; QFN50P300X300X80-17N-D; Mouser Part Number 595-BQ25302RTER
IC5: SI3483DDV-T1-BE3; SOT95P284X110-6N; Mouser Part Number 78-SI3483DDV-T1-BE3
J5: USB_B_Micro; USB_Micro-B_Amphenol_10118194_Horizontal
L4: 1uH; L_0805_2012Metric_Pad1.15x1.40mm_HandSolder
R1: 0.025; R_0805_2012Metric_Pad1.20x1.40mm_HandSolder
R17: 30.9k; R_0805_2012Metric_Pad1.20x1.40mm_HandSolder
R18, R21: 50m; R_0805_2012Metric_Pad1.20x1.40mm_HandSolder
R19: 4.52k; R_0805_2012Metric_Pad1.20x1.40mm_HandSolder
R20: 23.6k; R_0805_2012Metric_Pad1.20x1.40mm_HandSolder
TH1: Thermistor; 103AT2

Connections:
+Vpp: R18.2; also elsewhere on the board
BATTCH_EN: IC4.6 (~EN); also elsewhere on the board
BAT_I+: C17.1, IC4.10 (BAT), IC5.1 (D_1), IC5.2 (D_2), IC5.5 (D_3), IC5.6 (D_4), L4.2, R21.1; also elsewhere on the board
MPPT_I+: IC1.4 (VOUT); also elsewhere on the board
MPPT_I-: C13.1, D10.2 (A), IC4.1 (VBUS), J5.1 (VBUS); also elsewhere on the board
unnamed 54: IC1.3 (LX); also elsewhere on the board
unnamed: D10.1 (K), IC5.3 (G)
unnamed 75: IC1.5 (VCTRL); also elsewhere on the board
unnamed: C16.1, IC4.15 (BTST)
unnamed: IC4.4 (ICHG), R17.2
unnamed: C14.1, IC4.16 (PMID), IC5.4 (S), R18.1
unnamed: C16.2, IC4.13 (SW_1), IC4.14 (SW_2), L4.1
unnamed: IC4.7 (TS), R19.1, R20.2, TH1.1
REGN: C15.1, IC4.2 (REGN), R19.2
STAT: IC4.3 (STAT); also elsewhere on the board
USB_D+: J5.3 (D+); also elsewhere on the board
USB_D-: J5.2 (D-); also elsewhere on the board

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
