Cubesat-EPS-Project/Final_EPS_Version2/FinalBoardCircuits/FinalBoardCircuits.kicad_pcb

## KiCad design FinalBoardCircuits/FinalBoardCircuits.kicad_pcb (continued)

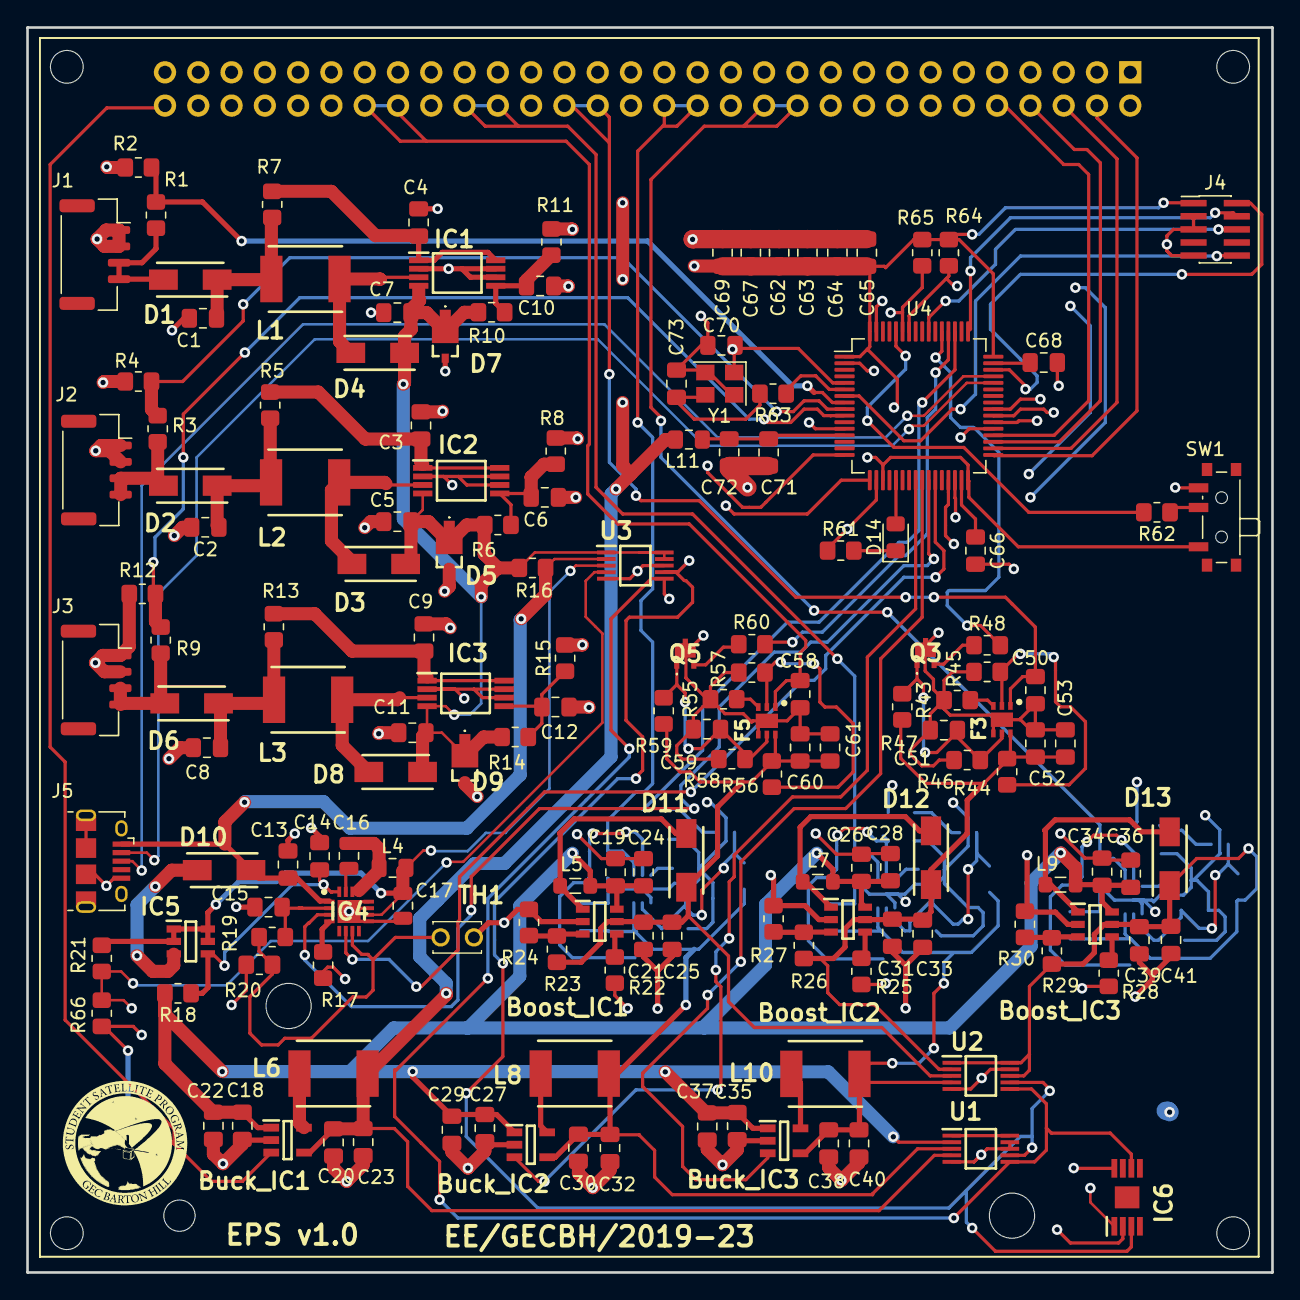
[picture p10: board FinalBoardCircuits.kicad_pcb from above]

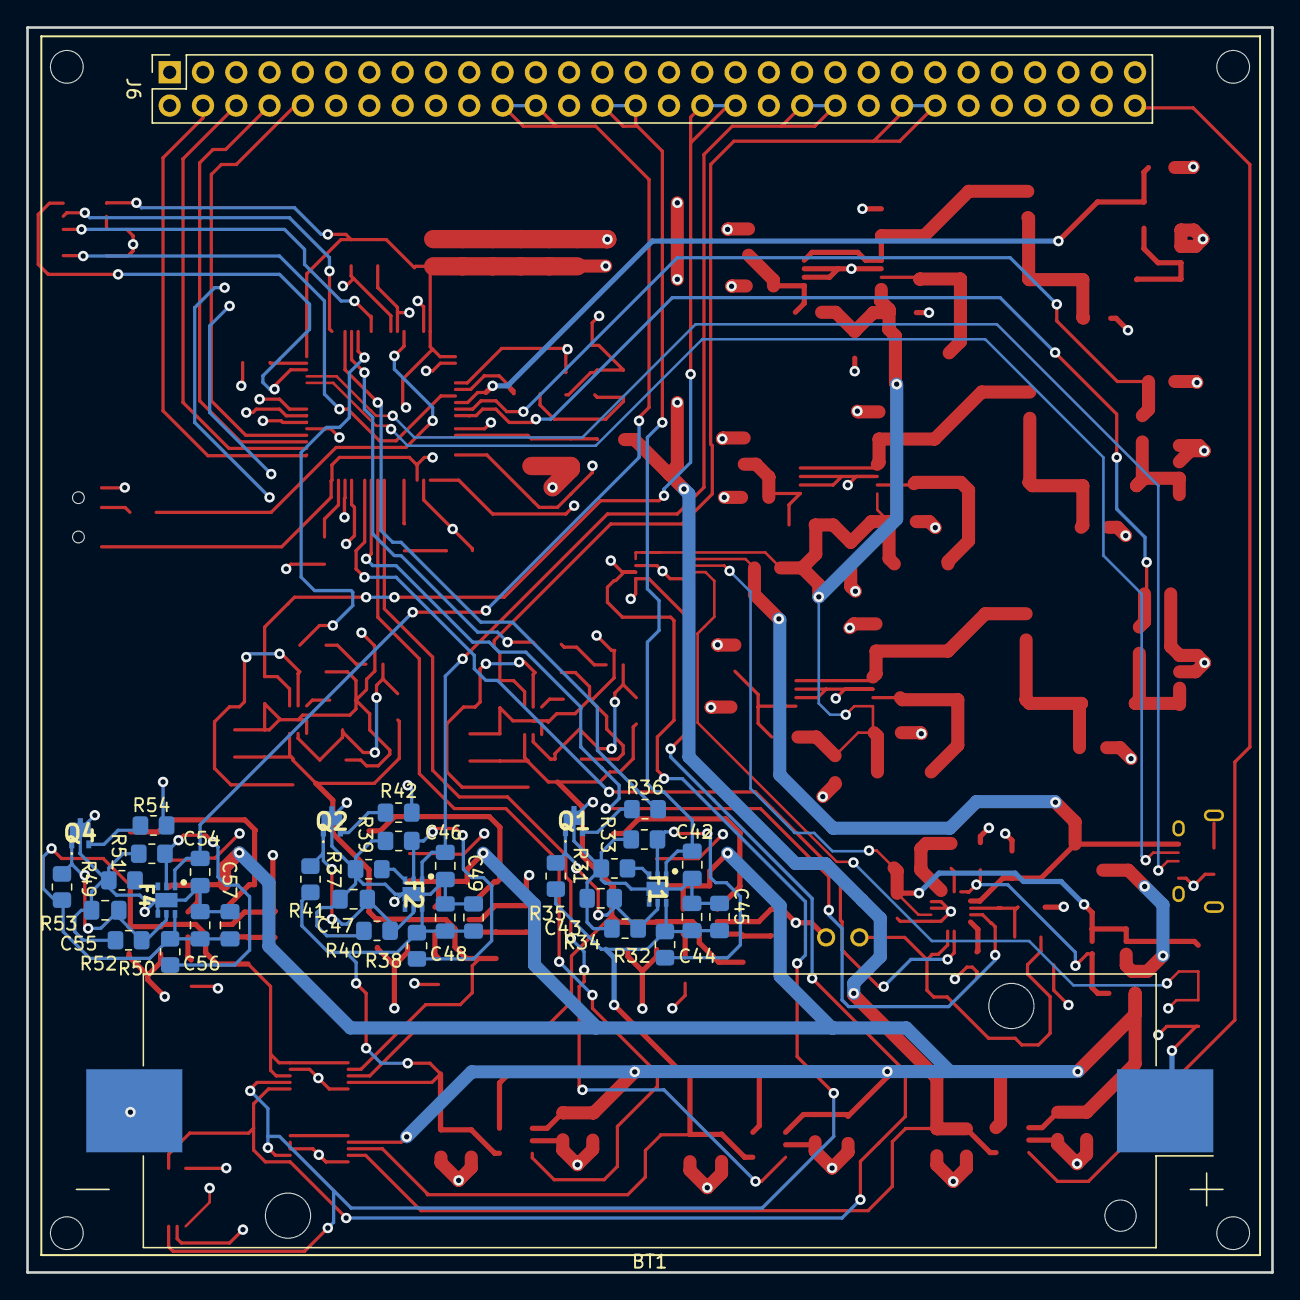
[picture p11: board FinalBoardCircuits.kicad_pcb from below]

Board: 4 copper layers, 95.0 x 95.0 mm, 200 parts (38 on the bottom side), 115 nets.

Other parts of the board:
IC6: LTC2941IMS8E#PBF; SOP65P490X110-9N
R66: 0.025; R_0805_2012Metric_Pad1.20x1.40mm_HandSolder

Their connections:
I2C1_SCL: IC6.3 (SCL); also elsewhere on the board
I2C1_SDA: IC6.6 (SDA); also elsewhere on the board
