Cubesat-EPS-Project/Final_EPS_Version2/(commit log)

2023-06-01 Final board 2nd version
    Final EPS board with 3 mppt, 1 battery charger, 3 5V regulator, 3 3.3V regulator, 6 overvoltage and overcurrent protection, and an stm32 chip in a PC104 architecture
    [BatteryCharger.kicad_sch, FinalBoardCircuits.kicad_pcb, FinalBoardCircuits.kicad_sch, MpptVersion2.kicad_sch, Protection.kicad_sch, Regulation.kicad_sch, STM32.kicad_sch, STM32F405Board.kicad_sch]
2023-06-03 Added fuel guage
    Added fuel guage circuit to the final design.
    [BatteryCharger.kicad_sch, FinalBoardCircuits.kicad_pcb, FinalBoardCircuits.kicad_sch, STM32.kicad_sch]
